juansetenorio/Infraestructuras-Verdes/(commit log)

2026-04-27 Add main firmware code for ESP32-S3
    Es el primer codigo de prueba con rasberry pi
2026-04-27 Revise README for green roof monitoring system
    Updated the README to provide detailed information about the green roof monitoring system, including objectives, architecture, sensors used, irrigation control, communication, and technologies.
2026-07-26 Actualización de README
    Se añade la información mas actualizada que se implementó en cada ESP32.
2026-07-26 Agregando código base del firmware ESP32
2026-07-26 Actualización de Readme
    Cambios en pines y en funcionamiento de electroválvula.
